OpenThingsIO/RFToy/hardware/1.x/README.md

RFToy 1.0/1.1 schematic and board design files.
