OpenThingsIO/RFToy/hardware/3.0/README.md

RFToy 3.0 reuses the top-layer (Master Controller) board of OpenSprinkler 3.0.
Go to:
https://github.com/OpenSprinkler/OpenSprinkler-Hardware/tree/master/OS/3.0/Master
to download the schematic and board design file.
