OpenThingsIO/RFToy/hardware/3.1/rftoy3.1_schematic.png

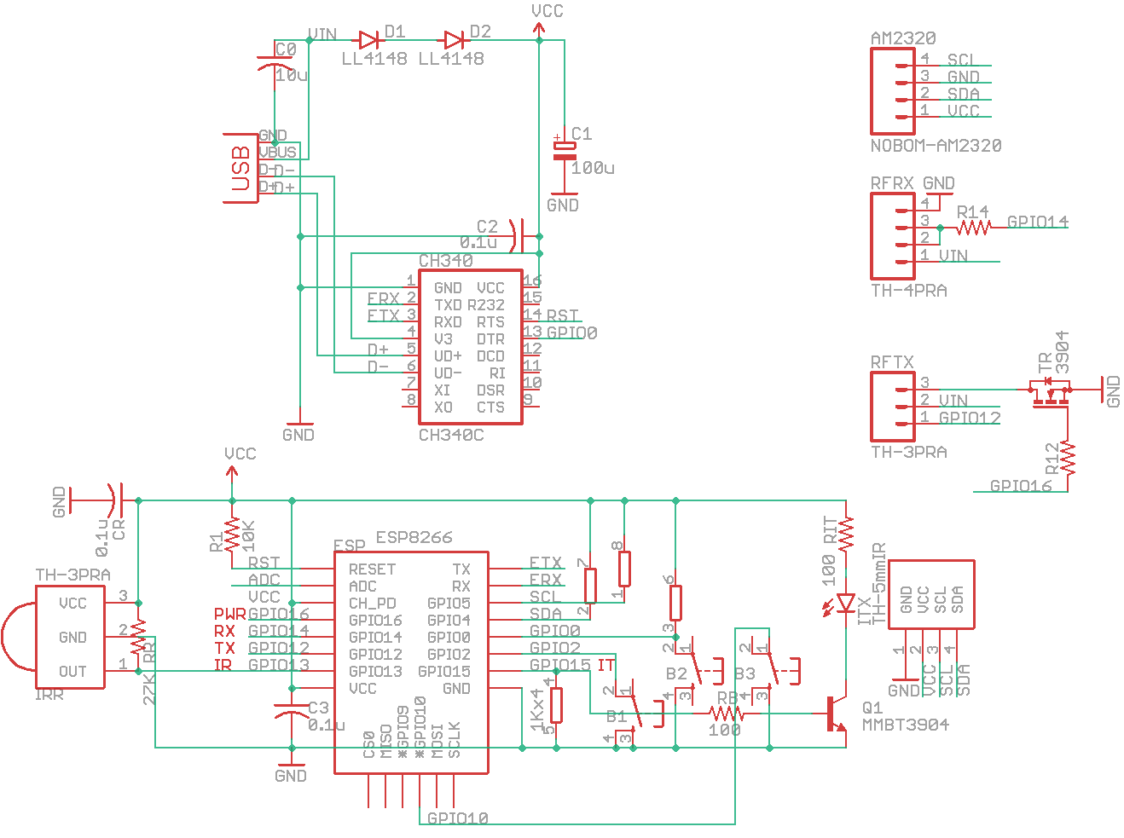
hardware/3.1/rftoy3.1_schematic.png
