OpenThingsIO/RFToy/hardware/3.1/rftoy31.brd

## EAGLE design hardware/3.1/rftoy31.brd (2021-10-29)

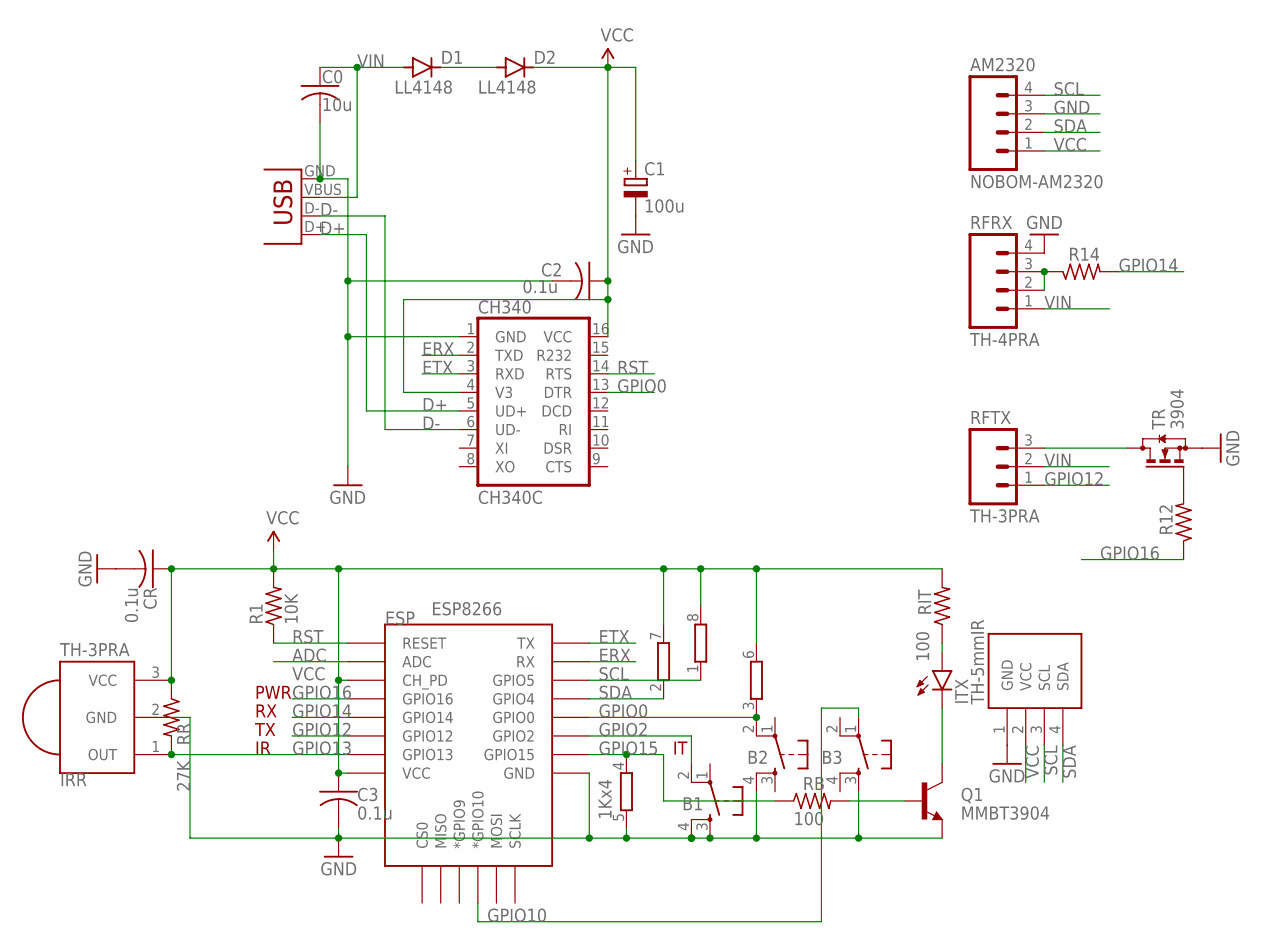
[picture p20: schematic rftoy31.sch]

Parts:
AM2320: NOBOM-AM2320; 1X04_NO_SILK
B1, B2, B3: TH-TACT6x9; EVQ-Q2-SMD
C0: 10u; C0805K
C1: 100u; PANASONIC_C
C2: 0.1u; C0603K
C3: 0.1u; C0603
CH340: CH340C; SO16
CR: 0.1u; C0603
D1, D2: LL4148; MINIMELF
ESP: ESP8266; ESP12E-SMD
IRR: TH-3PRA; PNA460XM
ITX: TH-5mmIR; IRL80A
LCD: NOBOM-OLED; SSD1306_OLED_I2C_PCB_0.75_B
Q1: MMBT3904; SOT23
R1: 10K; R0603
R12, R14: 1K; R0603
RB: 100; R0603
RFRX: TH-4PRA; 1X04_LONGPADS
RFTX: TH-3PRA; 1X03_NO_SILK
RIT: 100; R0603
RN1: 1Kx4; EXB38V
RR: 27K; R0603
TR: 3904; SOT23
X3: USBMICROB2; USB-MICROB2

Connections:
ADC: ESP.ADC
D+: CH340.5 (UD+), X3.D+
D-: CH340.6 (UD-), X3.D-
ERX: CH340.2 (TXD), ESP.RXD0 (RX)
ETX: CH340.3 (RXD), ESP.TXD0 (TX)
GND: AM2320.3, B1.3, B1.4, B2.4, B3.3, C0.2, C1.-, C2.2, C3.2, CH340.1 (GND), CR.2, ESP.GND, IRR.2 (GND), LCD.1 (GND), Q1.2 (E), RFRX.4, RN1.5 (2), TR.2 (S), X3.GND
GPIO0: B2.2, CH340.13 (DTR), ESP.GPIO0, RN1.3 (1)
GPIO2: B1.2, ESP.GPIO2
GPIO10: B3.1, ESP.GPIO10 (*GPIO10)
GPIO12: ESP.GPIO12, RFTX.1
GPIO13: ESP.GPIO13, IRR.1 (OUT), RR.2
GPIO14: ESP.GPIO14, R14.2
GPIO15: ESP.GPIO15, RB.1, RN1.4 (1)
GPIO16: ESP.GPIO16, R12.1
unnamed: D1.C, D2.A
unnamed: ITX.K (C), Q1.3 (C)
unnamed: Q1.1 (B), RB.2
unnamed: R12.2, TR.1 (G)
unnamed: ITX.A, RIT.1
unnamed: R14.1, RFRX.2, RFRX.3
unnamed: RFTX.3, TR.3 (D)
RST: CH340.14 (RTS), ESP.RESET, R1.1
SCL: AM2320.4, ESP.GPIO5, LCD.3 (SCL), RN1.1
SDA: AM2320.2, ESP.GPIO4, LCD.4 (SDA), RN1.2 (1)
VCC: AM2320.1, C1.+, C2.1, C3.1, CH340.4 (V3), CH340.16 (VCC), CR.1, D2.C, ESP.CH_PD, ESP.VCC, IRR.3 (VCC), LCD.2 (VCC), R1.2, RIT.2, RN1.6 (2), RN1.7 (2), RN1.8 (2), RR.1
VIN: C0.1, D1.A, RFRX.1, RFTX.2, X3.VBUS

Notes on the sheet:
PWR

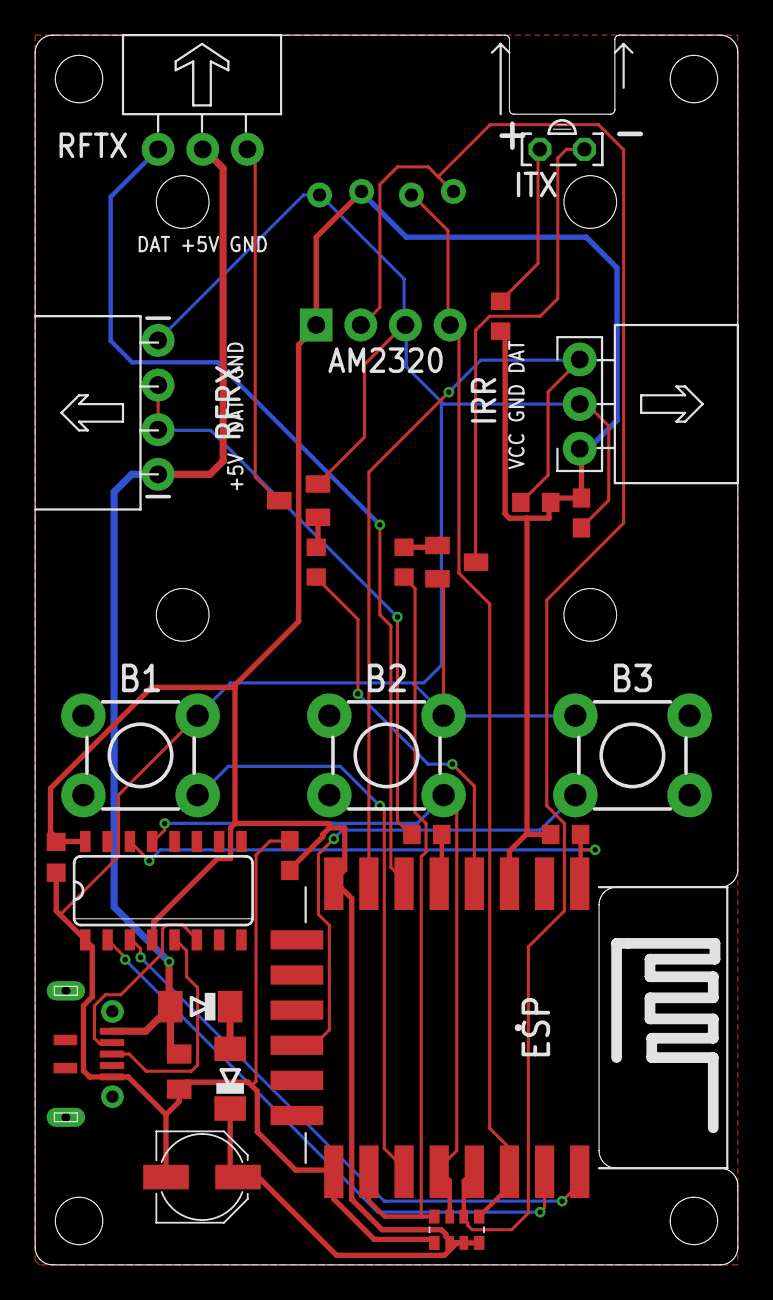
[picture p21: board rftoy31.brd from above]

Board: 2 copper layers, 40.0 x 70.0 mm, 28 parts (0 on the bottom side), 25 nets.
