OpenThingsIO/RFToy/hardware/1.x/rftoy1.1.brd

## EAGLE design hardware/1.x/rftoy1.1.brd (2018-03-06)

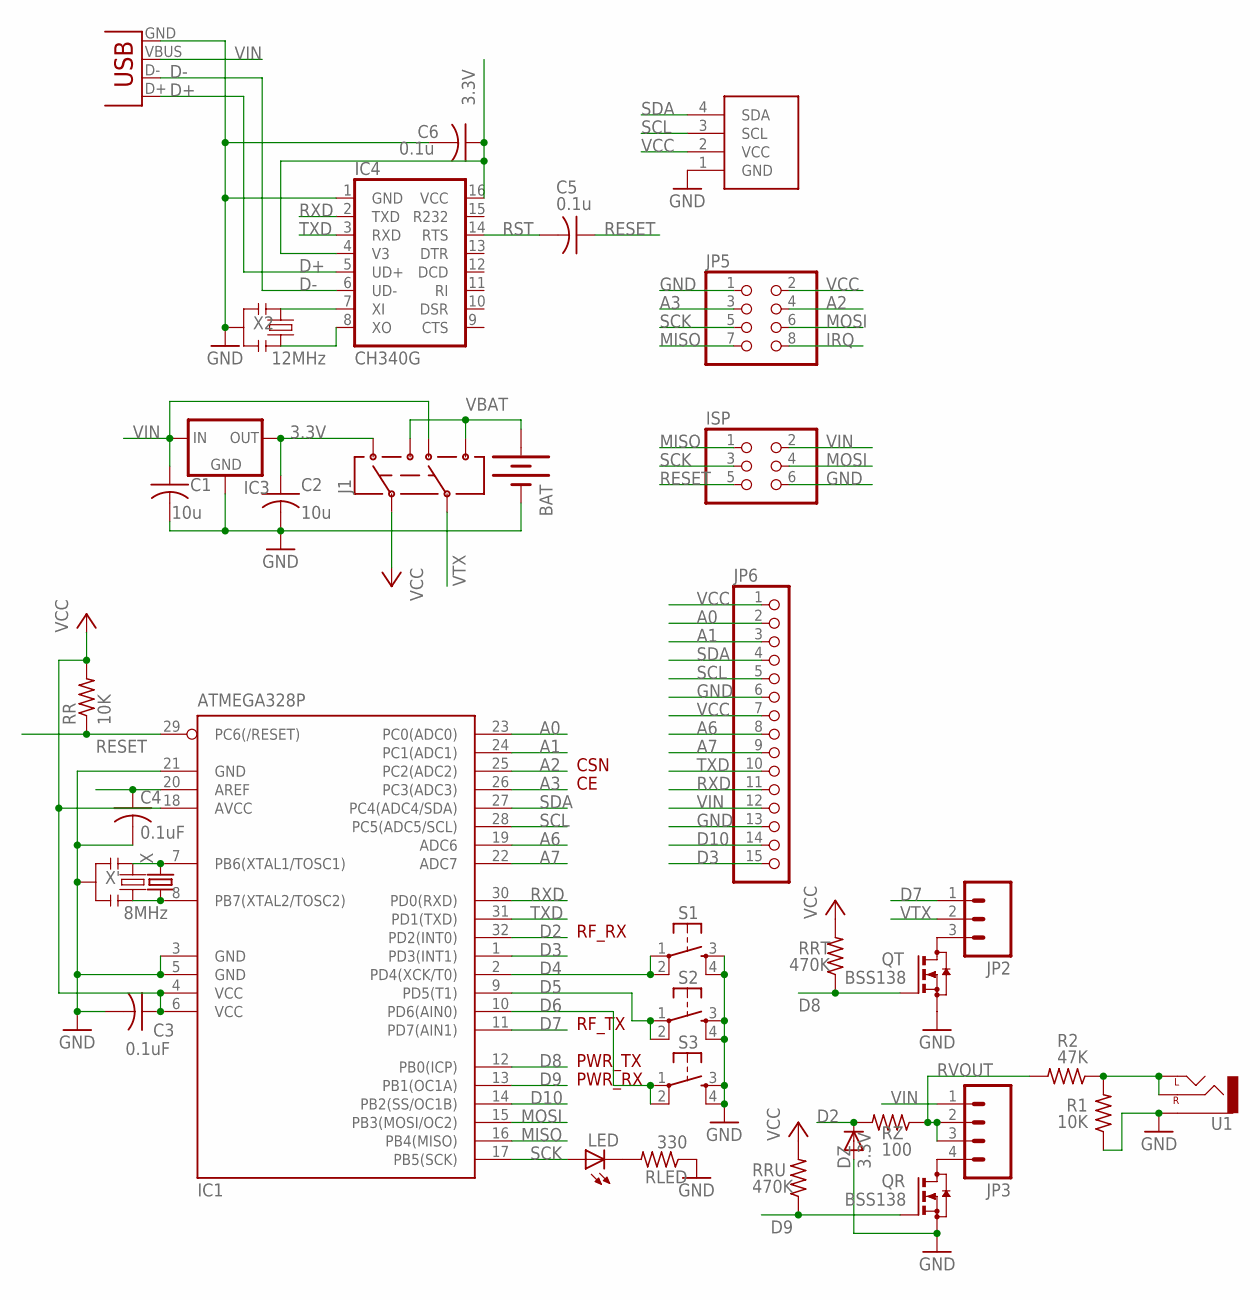
[picture p22: schematic rftoy1.1.sch]

Parts:
BAT: BATTERY20PTH; BATTCOM_20MM_PTH
C1, C2: 10u; C0805K
C3, C4: 0.1uF; C0603K
C5, C6: 0.1u; C0603K
DZ: 3.3V; MINIMELF
IC1: ATMEGA328P; TQFP32-08
IC3: MCP1700SOT233; SOT23
IC4: CH340G; SO16
ISP: PINHD-2X3; 2X03
J1: AYZ0202
JP2: M03LOCK_LONGPADS; 1X03_LOCK_LONGPADS
JP3: M04LOCK; 1X04_LOCK
JP5: PINHD-2X4; 2X04
JP6: PINHD-1X15-CB; 1X15-CB
LED: LEDCHIPLED_0805; CHIPLED_0805
QR: BSS138; SOT23
QT: BSS138; SOT23
R1: 10K; R0805
R2: 47K; R0805
RLED: 330; R0805
RR: 10K; R0805
RRT: 470K; R0805
RRU: 470K; R0805
RZ: 100; R0805
S1, S2, S3: TAC_SWITCHPTH; TACTILE-PTH
U1: AUDIO-JACKSMD3; AUDIO-JACK-3.5MM-SMD3
U$1: SSD1306_OLED_I2C
X: CRYSTALTC26V; TC26V
X1: USBSMD; USB-MINIB
X2: 12MHz; RESONATOR-SMD
X': 8MHz; RESONATOR-SMD

Connections:
3.3V: C2.1, C6.1, IC3.2 (OUT), IC4.4 (V3), IC4.16 (VCC), J1.3 (1)
A0: IC1.23 (PC0(ADC0)), JP6.2
A1: IC1.24 (PC1(ADC1)), JP6.3
A2: IC1.25 (PC2(ADC2)), JP5.4
A3: IC1.26 (PC3(ADC3)), JP5.3
A6: IC1.19 (ADC6), JP6.8
A7: IC1.22 (ADC7), JP6.9
AREF: C4.1, IC1.20 (AREF)
D2: DZ.C, IC1.32 (PD2(INT0)), RZ.2
D3: IC1.1 (PD3(INT1)), JP6.15
D4: IC1.2 (PD4(XCK/T0)), S1.1, S1.2
D5: IC1.9 (PD5(T1)), S2.1, S2.2
D6: IC1.10 (PD6(AIN0)), S3.1, S3.2
D7: IC1.11 (PD7(AIN1)), JP2.1
D8: IC1.12 (PB0(ICP)), QT.1 (G), RRT.1
D9: IC1.13 (PB1(OC1A)), QR.1 (G), RRU.1
D10: IC1.14 (PB2(SS/OC1B)), JP6.14
D+: IC4.5 (UD+), X1.D+
D-: IC4.6 (UD-), X1.D-
GND: BAT.2 (-), C1.2, C2.2, C3.2, C4.2, C6.2, DZ.A, IC1.3 (GND), IC1.5 (GND), IC1.21 (GND), IC3.1 (GND), IC4.1 (GND), ISP.6, JP5.1, JP6.6, JP6.13, QR.2 (S), QT.2 (S), R1.1, RLED.1, S1.3, S1.4, S2.3, S2.4, S3.3, S3.4, U1.RING (SLEEVE), U$1.1 (GND), X1.GND, X2.2, X'.2
IRQ: JP5.8
MISO: IC1.16 (PB4(MISO)), ISP.1, JP5.7
MOSI: IC1.15 (PB3(MOSI/OC2)), ISP.4, JP5.6
unnamed: LED.C, RLED.2
unnamed: IC1.7 (PB6(XTAL1/TOSC1)), X.2, X'.1
unnamed: IC1.8 (PB7(XTAL2/TOSC2)), X.1, X'.3
unnamed: R1.2, R2.1, U1.MID (RIGHT), U1.TIP (LEFT)
unnamed: JP3.4, QR.3 (D)
unnamed: JP2.3, QT.3 (D)
unnamed: IC4.7 (XI), X2.1
unnamed: IC4.8 (XO), X2.3
RESET: C5.1, IC1.29 (PC6(/RESET)), ISP.5, RR.1
RST: C5.2, IC4.14 (RTS)
RVOUT: JP3.2, JP3.3, R2.2, RZ.1
RXD: IC1.30 (PD0(RXD)), IC4.2 (TXD), JP6.11
SCK: IC1.17 (PB5(SCK)), ISP.3, JP5.5, LED.A
SCL: IC1.28 (PC5(ADC5/SCL)), JP6.5, U$1.3 (SCL)
SDA: IC1.27 (PC4(ADC4/SDA)), JP6.4, U$1.4 (SDA)
TXD: IC1.31 (PD1(TXD)), IC4.3 (RXD), JP6.10
VBAT: BAT.1 (+), J1.1 (3), J1.4 (6)
VCC: C3.1, IC1.4 (VCC), IC1.6 (VCC), IC1.18 (AVCC), J1.2, JP5.2, JP6.1, JP6.7, RR.2, RRT.2, RRU.2, U$1.2 (VCC)
VIN: C1.1, IC3.3 (IN), ISP.2, J1.6 (4), JP3.1, JP6.12, X1.VBUS
VTX: J1.5, JP2.2

Notes on the sheet:
RF_RX
PWR_RX
PWR_TX
RF_TX
CSN

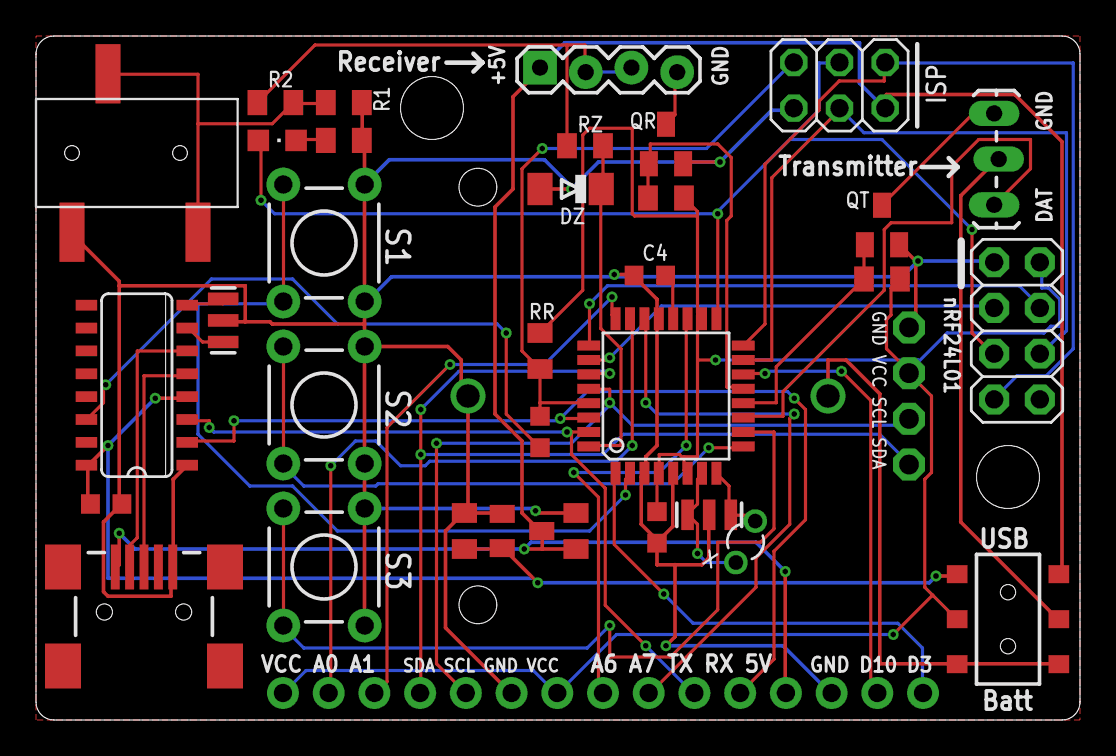
[picture p23: board rftoy1.1.brd from above]

Board: 2 copper layers, 58.0 x 38.0 mm, 36 parts (1 on the bottom side), 42 nets.
