OpenThingsIO/RFToy/firmware/3.1/LibrationFont.h

// Created by http://oleddisplay.squix.ch/ Consider a donation
// In case of problems make sure that you are using the font file with the correct version!
const uint8_t Liberation_Mono_10[] PROGMEM = {
	0x06, // Width: 6
	0x0C, // Height: 12
	0x20, // First Char: 32
	0xE0, // Numbers of Chars: 224

	// Jump Table:
	0xFF, 0xFF, 0x00, 0x06,  // 32:65535
	0x00, 0x00, 0x08, 0x06,  // 33:0
	0x00, 0x08, 0x07, 0x06,  // 34:8
	0x00, 0x0F, 0x0B, 0x06,  // 35:15
	0x00, 0x1A, 0x0B, 0x06,  // 36:26
	0x00, 0x25, 0x0C, 0x06,  // 37:37
	0x00, 0x31, 0x0C, 0x06,  // 38:49
	0x00, 0x3D, 0x07, 0x06,  // 39:61
	0x00, 0x44, 0x08, 0x06,  // 40:68
	0x00, 0x4C, 0x08, 0x06,  // 41:76
	0x00, 0x54, 0x09, 0x06,  // 42:84
	0x00, 0x5D, 0x0B, 0x06,  // 43:93
	0x00, 0x68, 0x06, 0x06,  // 44:104
	0x00, 0x6E, 0x07, 0x06,  // 45:110
	0x00, 0x75, 0x06, 0x06,  // 46:117
	0x00, 0x7B, 0x09, 0x06,  // 47:123
	0x00, 0x84, 0x0B, 0x06,  // 48:132
	0x00, 0x8F, 0x0C, 0x06,  // 49:143
	0x00, 0x9B, 0x0A, 0x06,  // 50:155
	0x00, 0xA5, 0x09, 0x06,  // 51:165
	0x00, 0xAE, 0x0B, 0x06,  // 52:174
	0x00, 0xB9, 0x09, 0x06,  // 53:185
	0x00, 0xC2, 0x0B, 0x06,  // 54:194
	0x00, 0xCD, 0x09, 0x06,  // 55:205
	0x00, 0xD6, 0x0B, 0x06,  // 56:214
	0x00, 0xE1, 0x0B, 0x06,  // 57:225
	0x00, 0xEC, 0x06, 0x06,  // 58:236
	0x00, 0xF2, 0x06, 0x06,  // 59:242
	0x00, 0xF8, 0x0B, 0x06,  // 60:248
	0x01, 0x03, 0x09, 0x06,  // 61:259
	0x01, 0x0C, 0x0B, 0x06,  // 62:268
	0x01, 0x17, 0x09, 0x06,  // 63:279
	0x01, 0x20, 0x0C, 0x06,  // 64:288
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
	0x00,0x00,0xFC,0x01,0x24,0x01,0x24,0x01,0x24,0x01,0x04,0x01,	// 69
	0x00,0x00,0xFC,0x01,0x24,0x00,0x24,0x00,0x24,	// 70
	0x00,0x00,0xF8,0x00,0x8C,0x01,0x04,0x01,0x24,0x01,0xE8,	// 71
	0x00,0x00,0xFC,0x01,0x20,0x00,0x20,0x00,0xFC,0x01,	// 72
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
};
