OpenThingsIO/RFToy/(commit log)

2018-03-06 add readme and older files
    [rftoy1.0.brd, rftoy1.0.sch, rftoy1.1.brd, rftoy1.1.sch]
2021-10-29 add hardware 3.1 design files; firmware 3.1; update documents
    [rftoy31.brd, rftoy31.sch]
