OpenThingsIO/RFToy/(notices)

Notices in the files:
firmware/3.1/RFToy.ino:
This program is free software: you can redistribute it and/or modify
it under the terms of the GNU General Public License as published by
the Free Software Foundation, either version 3 of the License, or
(at your option) any later version.
parts and their libraries:
SparkFunNew: Licensing: CC v3.0 Share-Alike You are welcome to use this library for commercial purposes.
